qetad13/8bit-bcd-adder-subtractor/docs/block_diagram.png

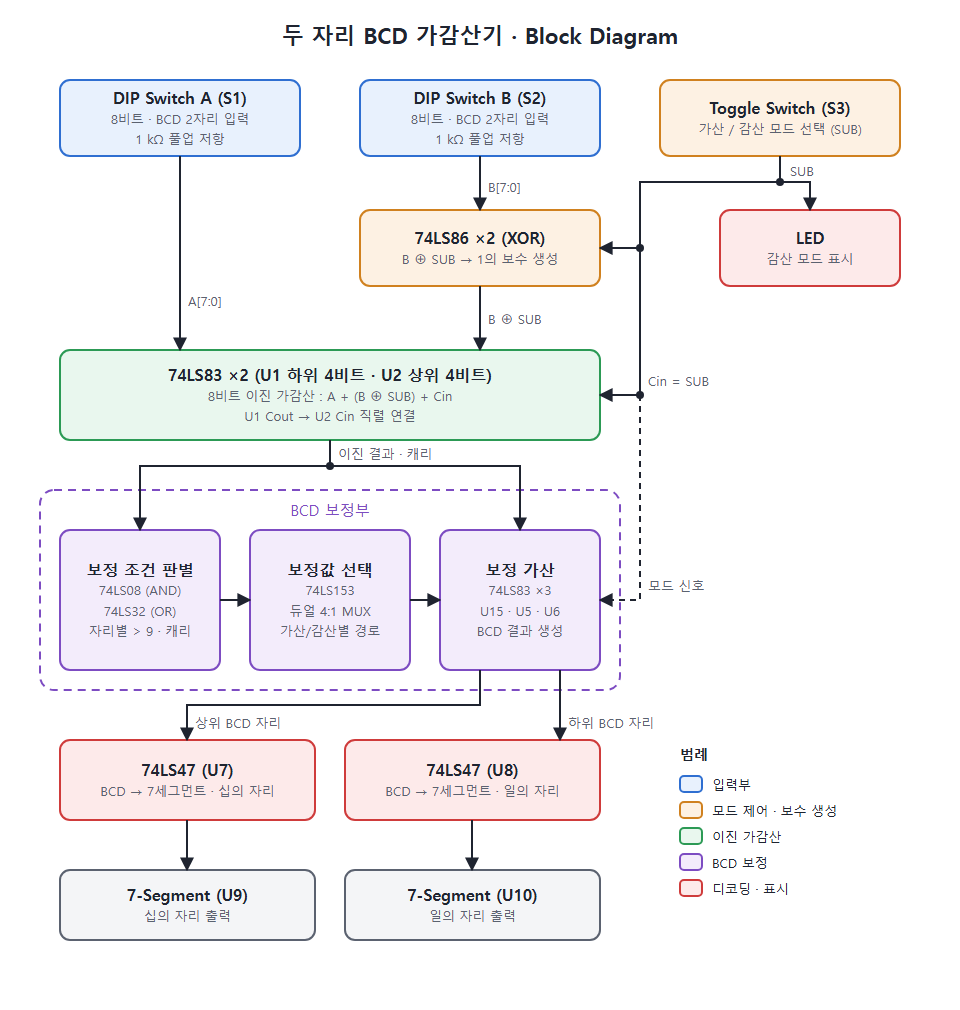
docs/block_diagram.png
