qetad13/8bit-bcd-adder-subtractor/docs/flowchart.png

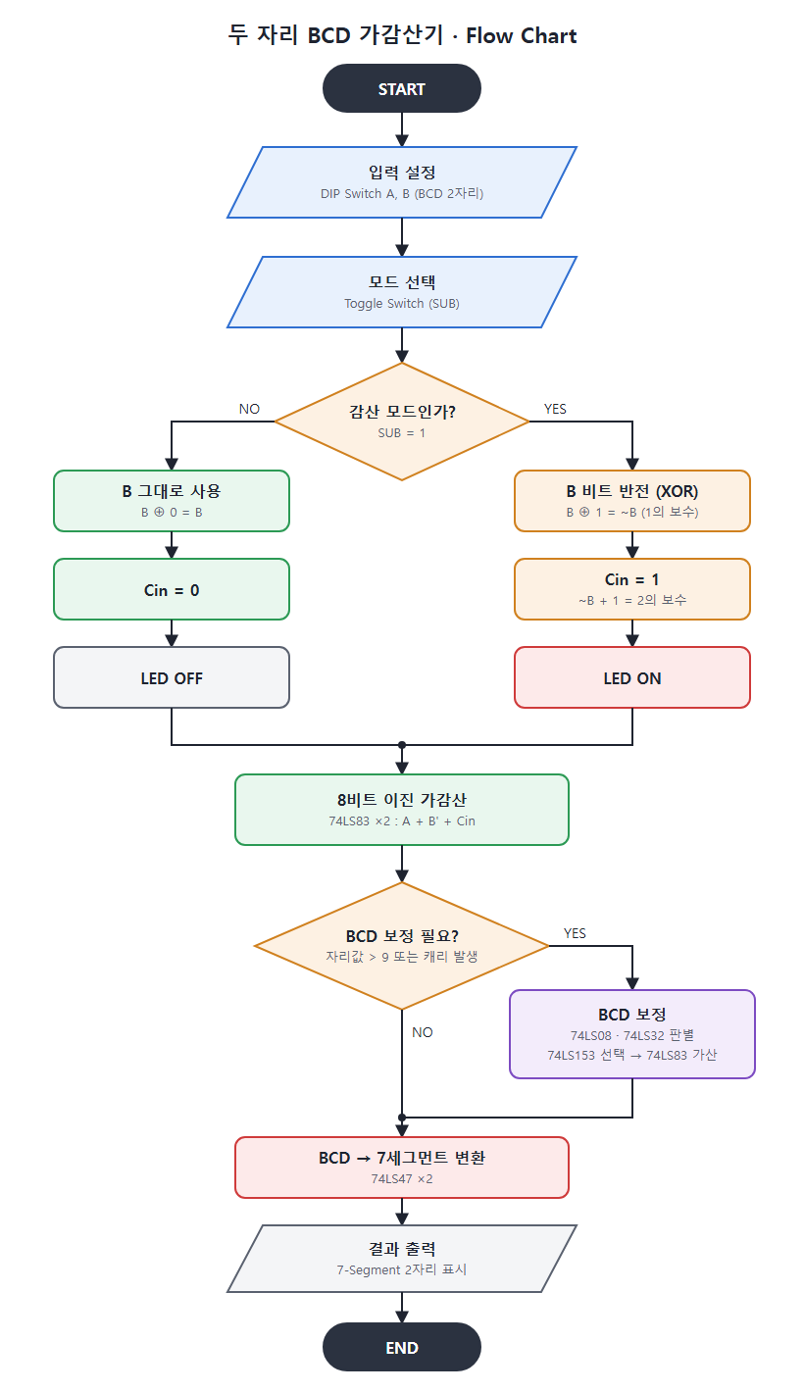
docs/flowchart.png
