qetad13/8bit-bcd-adder-subtractor/images/schematic.png

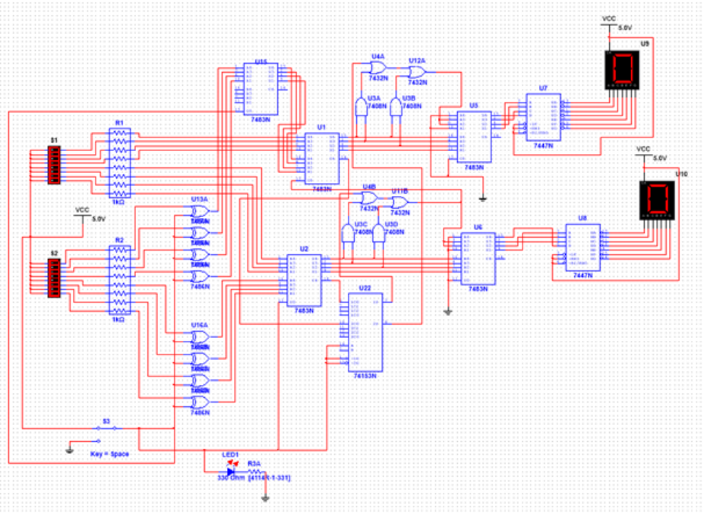
images/schematic.png
