qetad13/8bit-bcd-adder-subtractor/(list of files, drawings)

Other design files:
circuit/bcd_adder_subtractor_final.ms14
