qetad13/8bit-bcd-adder-subtractor/(commit log)

2026-10-07 Add 2-digit BCD adder/subtractor term project
    Final Multisim circuit, redrawn block diagram and flow chart,
    simulation/breadboard/final product photos, and demo videos.
    [bcd_adder_subtractor_final.ms14]
2026-10-23 README 표기 정리, 영상 썸네일 및 라이선스 추가
    - 검증 항목의 '실물'을 결과 표와 같은 '브레드보드'로 통일
    - 트러블슈팅 2번의 IC 개수(초기 7개 / 최종 12개) 명확화
    - 동작 영상 썸네일 추가
    - MIT LICENSE 추가
